ChipDesign-BV/sg13g2_stdcell_hv/spice/sg13g2_stdcell_hv.spice

************************************************************************
*
* sg13g2_stdcell_hv -- thick-oxide (3.3 V) standard cell library
*
* Derived from the IHP SG13G2 sg13g2_stdcell thin-oxide library by
* substituting the 3.3 V thick-oxide devices. Topology, pin names and pin
* order are unchanged from the thin-oxide cells.
*
*   model   sg13_lv_{n,p}mos -> sg13_hv_{n,p}mos
*   length  L -> max(L, 450 nm)     DRC Gat.a3, min gate length of the 3.3 V FET
*   width   NMOS unchanged; PMOS x 2.4
*           so the inverter switching threshold stays at Vm/VDD = 0.5046,
*           the value the thin-oxide library is sized to
*   as/ad/ps/pd recomputed from the HV model deck geometry (z1=0.34u, z2=0.38u)
*
* Generated 2026-08-03 by work/gen_hv_lib.py
*
* Original library Copyright 2023 IHP PDK Authors, Apache License 2.0.
* This derived work is distributed under the same terms.
*
************************************************************************


* Library name: sg13g2_stdcell_hv
* Cell name: sg13g2_hv_a21o_1
* View name: schematic
.subckt sg13g2_hv_a21o_1 X A1 A2 B1 VDD VSS
XN0 net1 A1 net2 VSS sg13_hv_nmos w=0.640u l=0.450u ng=1 ad=2.176e-13 as=2.176e-13 pd=1.96e-06 ps=1.96e-06 m=1
XN1 net2 A2 VSS VSS sg13_hv_nmos w=0.640u l=0.450u ng=1 ad=2.176e-13 as=2.176e-13 pd=1.96e-06 ps=1.96e-06 m=1
XN2 net1 B1 VSS VSS sg13_hv_nmos w=0.640u l=0.450u ng=1 ad=2.176e-13 as=2.176e-13 pd=1.96e-06 ps=1.96e-06 m=1
XN3 X net1 VSS VSS sg13_hv_nmos w=0.740u l=0.450u ng=1 ad=2.516e-13 as=2.516e-13 pd=2.16e-06 ps=2.16e-06 m=1
XP2 net1 B1 net3 VDD sg13_hv_pmos w=2.400u l=0.450u ng=1 ad=8.16e-13 as=8.16e-13 pd=5.48e-06 ps=5.48e-06 m=1
XP0 net3 A1 VDD VDD sg13_hv_pmos w=2.400u l=0.450u ng=1 ad=8.16e-13 as=8.16e-13 pd=5.48e-06 ps=5.48e-06 m=1
XP1 net3 A2 VDD VDD sg13_hv_pmos w=2.400u l=0.450u ng=1 ad=8.16e-13 as=8.16e-13 pd=5.48e-06 ps=5.48e-06 m=1
XP3 X net1 VDD VDD sg13_hv_pmos w=2.690u l=0.450u ng=1 ad=9.146e-13 as=9.146e-13 pd=6.06e-06 ps=6.06e-06 m=1
.ends
* End of subcircuit definition.

* Library name: sg13g2_stdcell_hv
* Cell name: sg13g2_hv_a21o_2
* View name: schematic
.subckt sg13g2_hv_a21o_2 X A1 A2 B1 VDD VSS
XN0 net1 A1 net2 VSS sg13_hv_nmos w=0.740u l=0.450u ng=1 ad=2.516e-13 as=2.516e-13 pd=2.16e-06 ps=2.16e-06 m=1
XN1 net2 A2 VSS VSS sg13_hv_nmos w=0.740u l=0.450u ng=1 ad=2.516e-13 as=2.516e-13 pd=2.16e-06 ps=2.16e-06 m=1
XN2 net1 B1 VSS VSS sg13_hv_nmos w=0.740u l=0.450u ng=1 ad=2.516e-13 as=2.516e-13 pd=2.16e-06 ps=2.16e-06 m=1
XN3 X net1 VSS VSS sg13_hv_nmos w=1.480u l=0.450u ng=2 ad=2.812e-13 as=5.032e-13 pd=2.24e-06 ps=4.32e-06 m=1
XP2 net1 B1 net3 VDD sg13_hv_pmos w=2.400u l=0.450u ng=1 ad=8.16e-13 as=8.16e-13 pd=5.48e-06 ps=5.48e-06 m=1
XP0 net3 A1 VDD VDD sg13_hv_pmos w=2.400u l=0.450u ng=1 ad=8.16e-13 as=8.16e-13 pd=5.48e-06 ps=5.48e-06 m=1
XP1 net3 A2 VDD VDD sg13_hv_pmos w=2.400u l=0.450u ng=1 ad=8.16e-13 as=8.16e-13 pd=5.48e-06 ps=5.48e-06 m=1
XP3 X net1 VDD VDD sg13_hv_pmos w=5.380u l=0.450u ng=2 ad=1.0222e-12 as=1.8292e-12 pd=6.14e-06 ps=1.212e-05 m=1
.ends
* End of subcircuit definition.

* Library name: sg13g2_stdcell_hv
* Cell name: sg13g2_hv_a21oi_1
* View name: schematic
.subckt sg13g2_hv_a21oi_1 Y A1 A2 B1 VDD VSS
XN0 Y B1 VSS VSS sg13_hv_nmos w=0.740u l=0.450u ng=1 ad=2.516e-13 as=2.516e-13 pd=2.16e-06 ps=2.16e-06 m=1
XN2 net1 A2 VSS VSS sg13_hv_nmos w=0.740u l=0.450u ng=1 ad=2.516e-13 as=2.516e-13 pd=2.16e-06 ps=2.16e-06 m=1
XN1 Y A1 net1 VSS sg13_hv_nmos w=0.740u l=0.450u ng=1 ad=2.516e-13 as=2.516e-13 pd=2.16e-06 ps=2.16e-06 m=1
XP2 Y B1 net2 VDD sg13_hv_pmos w=2.690u l=0.450u ng=1 ad=9.146e-13 as=9.146e-13 pd=6.06e-06 ps=6.06e-06 m=1
XP1 net2 A2 VDD VDD sg13_hv_pmos w=2.690u l=0.450u ng=1 ad=9.146e-13 as=9.146e-13 pd=6.06e-06 ps=6.06e-06 m=1
XP0 net2 A1 VDD VDD sg13_hv_pmos w=2.690u l=0.450u ng=1 ad=9.146e-13 as=9.146e-13 pd=6.06e-06 ps=6.06e-06 m=1
.ends
* End of subcircuit definition.

* Library name: sg13g2_stdcell_hv
* Cell name: sg13g2_hv_a21oi_2
* View name: schematic
.subckt sg13g2_hv_a21oi_2 Y A1 A2 B1 VDD VSS
XN0 Y B1 VSS VSS sg13_hv_nmos w=1.480u l=0.450u ng=2 ad=2.812e-13 as=5.032e-13 pd=2.24e-06 ps=4.32e-06 m=1
XN2 net2 A2 VSS VSS sg13_hv_nmos w=1.480u l=0.450u ng=2 ad=2.812e-13 as=5.032e-13 pd=2.24e-06 ps=4.32e-06 m=1
XN1 Y A1 net2 VSS sg13_hv_nmos w=1.480u l=0.450u ng=2 ad=2.812e-13 as=5.032e-13 pd=2.24e-06 ps=4.32e-06 m=1
XP2 Y B1 net1 VDD sg13_hv_pmos w=5.380u l=0.450u ng=2 ad=1.0222e-12 as=1.8292e-12 pd=6.14e-06 ps=1.212e-05 m=1
XP1 net1 A2 VDD VDD sg13_hv_pmos w=5.380u l=0.450u ng=2 ad=1.0222e-12 as=1.8292e-12 pd=6.14e-06 ps=1.212e-05 m=1
XP0 net1 A1 VDD VDD sg13_hv_pmos w=5.380u l=0.450u ng=2 ad=1.0222e-12 as=1.8292e-12 pd=6.14e-06 ps=1.212e-05 m=1
.ends
* End of subcircuit definition.

* Library name: sg13g2_stdcell_hv
* Cell name: sg13g2_hv_a221oi_1
* View name: schematic
.subckt sg13g2_hv_a221oi_1 Y A1 A2 B1 B2 C1 VDD VSS
XP2 Y C1 net3 VDD sg13_hv_pmos w=2.690u l=0.450u ng=1 ad=9.146e-13 as=9.146e-13 pd=6.06e-06 ps=6.06e-06 m=1
XP4 net3 B2 net1 VDD sg13_hv_pmos w=2.690u l=0.450u ng=1 ad=9.146e-13 as=9.146e-13 pd=6.06e-06 ps=6.06e-06 m=1
XP1 net3 B1 net1 VDD sg13_hv_pmos w=2.690u l=0.450u ng=1 ad=9.146e-13 as=9.146e-13 pd=6.06e-06 ps=6.06e-06 m=1
XP3 net1 A2 VDD VDD sg13_hv_pmos w=2.690u l=0.450u ng=1 ad=9.146e-13 as=9.146e-13 pd=6.06e-06 ps=6.06e-06 m=1
XP0 net1 A1 VDD VDD sg13_hv_pmos w=2.690u l=0.450u ng=1 ad=9.146e-13 as=9.146e-13 pd=6.06e-06 ps=6.06e-06 m=1
XN4 Y C1 VSS VSS sg13_hv_nmos w=0.740u l=0.450u ng=1 ad=2.516e-13 as=2.516e-13 pd=2.16e-06 ps=2.16e-06 m=1
XN3 net4 B2 VSS VSS sg13_hv_nmos w=0.740u l=0.450u ng=1 ad=2.516e-13 as=2.516e-13 pd=2.16e-06 ps=2.16e-06 m=1
XN2 Y B1 net4 VSS sg13_hv_nmos w=0.740u l=0.450u ng=1 ad=2.516e-13 as=2.516e-13 pd=2.16e-06 ps=2.16e-06 m=1
XN1 net2 A2 VSS VSS sg13_hv_nmos w=0.740u l=0.450u ng=1 ad=2.516e-13 as=2.516e-13 pd=2.16e-06 ps=2.16e-06 m=1
XN0 Y A1 net2 VSS sg13_hv_nmos w=0.740u l=0.450u ng=1 ad=2.516e-13 as=2.516e-13 pd=2.16e-06 ps=2.16e-06 m=1
.ends
* End of subcircuit definition.

* Library name: sg13g2_stdcell_hv
* Cell name: sg13g2_hv_and2_1
* View name: schematic
.subckt sg13g2_hv_and2_1 X A B VDD VSS
XN0 net4 A net2 VSS sg13_hv_nmos w=0.640u l=0.450u ng=1 ad=2.176e-13 as=2.176e-13 pd=1.96e-06 ps=1.96e-06 m=1
XN2 X net4 VSS VSS sg13_hv_nmos w=0.740u l=0.450u ng=1 ad=2.516e-13 as=2.516e-13 pd=2.16e-06 ps=2.16e-06 m=1
XN1 net2 B VSS VSS sg13_hv_nmos w=0.640u l=0.450u ng=1 ad=2.176e-13 as=2.176e-13 pd=1.96e-06 ps=1.96e-06 m=1
XP0 net4 B VDD VDD sg13_hv_pmos w=2.015u l=0.450u ng=1 ad=6.851e-13 as=6.851e-13 pd=4.71e-06 ps=4.71e-06 m=1
XP2 X net4 VDD VDD sg13_hv_pmos w=2.690u l=0.450u ng=1 ad=9.146e-13 as=9.146e-13 pd=6.06e-06 ps=6.06e-06 m=1
XP1 net4 A VDD VDD sg13_hv_pmos w=2.015u l=0.450u ng=1 ad=6.851e-13 as=6.851e-13 pd=4.71e-06 ps=4.71e-06 m=1
.ends
* End of subcircuit definition.

* Library name: sg13g2_stdcell_hv
* Cell name: sg13g2_hv_and2_2
* View name: schematic
.subckt sg13g2_hv_and2_2 X A B VDD VSS
XN0 net1 A net2 VSS sg13_hv_nmos w=0.640u l=0.450u ng=1 ad=2.176e-13 as=2.176e-13 pd=1.96e-06 ps=1.96e-06 m=1
XN2 X net1 VSS VSS sg13_hv_nmos w=1.480u l=0.450u ng=2 ad=2.812e-13 as=5.032e-13 pd=2.24e-06 ps=4.32e-06 m=1
XN1 net2 B VSS VSS sg13_hv_nmos w=0.640u l=0.450u ng=1 ad=2.176e-13 as=2.176e-13 pd=1.96e-06 ps=1.96e-06 m=1
XP0 net1 B VDD VDD sg13_hv_pmos w=2.015u l=0.450u ng=1 ad=6.851e-13 as=6.851e-13 pd=4.71e-06 ps=4.71e-06 m=1
XP2 X net1 VDD VDD sg13_hv_pmos w=5.380u l=0.450u ng=2 ad=1.0222e-12 as=1.8292e-12 pd=6.14e-06 ps=1.212e-05 m=1
XP1 net1 A VDD VDD sg13_hv_pmos w=2.015u l=0.450u ng=1 ad=6.851e-13 as=6.851e-13 pd=4.71e-06 ps=4.71e-06 m=1
.ends
* End of subcircuit definition.

* Library name: sg13g2_stdcell_hv
* Cell name: sg13g2_hv_and3_1
* View name: schematic
.subckt sg13g2_hv_and3_1 X A B C VDD VSS
XN2 net3 C VSS VSS sg13_hv_nmos w=0.640u l=0.450u ng=1 ad=2.176e-13 as=2.176e-13 pd=1.96e-06 ps=1.96e-06 m=1
XN3 X net2 VSS VSS sg13_hv_nmos w=0.740u l=0.450u ng=1 ad=2.516e-13 as=2.516e-13 pd=2.16e-06 ps=2.16e-06 m=1
XN0 net2 A net1 VSS sg13_hv_nmos w=0.640u l=0.450u ng=1 ad=2.176e-13 as=2.176e-13 pd=1.96e-06 ps=1.96e-06 m=1
XN1 net1 B net3 VSS sg13_hv_nmos w=0.640u l=0.450u ng=1 ad=2.176e-13 as=2.176e-13 pd=1.96e-06 ps=1.96e-06 m=1
XP3 X net2 VDD VDD sg13_hv_pmos w=2.690u l=0.450u ng=1 ad=9.146e-13 as=9.146e-13 pd=6.06e-06 ps=6.06e-06 m=1
XP1 net2 B VDD VDD sg13_hv_pmos w=2.015u l=0.450u ng=1 ad=6.851e-13 as=6.851e-13 pd=4.71e-06 ps=4.71e-06 m=1
XP2 net2 A VDD VDD sg13_hv_pmos w=2.015u l=0.450u ng=1 ad=6.851e-13 as=6.851e-13 pd=4.71e-06 ps=4.71e-06 m=1
XP0 net2 C VDD VDD sg13_hv_pmos w=2.015u l=0.450u ng=1 ad=6.851e-13 as=6.851e-13 pd=4.71e-06 ps=4.71e-06 m=1
.ends
* End of subcircuit definition.

* Library name: sg13g2_stdcell_hv
* Cell name: sg13g2_hv_and3_2
* View name: schematic
.subckt sg13g2_hv_and3_2 X A B C VDD VSS
XN2 net3 C VSS VSS sg13_hv_nmos w=0.640u l=0.450u ng=1 ad=2.176e-13 as=2.176e-13 pd=1.96e-06 ps=1.96e-06 m=1
XN3 X net2 VSS VSS sg13_hv_nmos w=1.480u l=0.450u ng=2 ad=2.812e-13 as=5.032e-13 pd=2.24e-06 ps=4.32e-06 m=1
XN0 net2 A net1 VSS sg13_hv_nmos w=0.640u l=0.450u ng=1 ad=2.176e-13 as=2.176e-13 pd=1.96e-06 ps=1.96e-06 m=1
XN1 net1 B net3 VSS sg13_hv_nmos w=0.640u l=0.450u ng=1 ad=2.176e-13 as=2.176e-13 pd=1.96e-06 ps=1.96e-06 m=1
XP3 X net2 VDD VDD sg13_hv_pmos w=5.380u l=0.450u ng=2 ad=1.0222e-12 as=1.8292e-12 pd=6.14e-06 ps=1.212e-05 m=1
XP1 net2 B VDD VDD sg13_hv_pmos w=2.015u l=0.450u ng=1 ad=6.851e-13 as=6.851e-13 pd=4.71e-06 ps=4.71e-06 m=1
XP2 net2 A VDD VDD sg13_hv_pmos w=2.015u l=0.450u ng=1 ad=6.851e-13 as=6.851e-13 pd=4.71e-06 ps=4.71e-06 m=1
XP0 net2 C VDD VDD sg13_hv_pmos w=2.015u l=0.450u ng=1 ad=6.851e-13 as=6.851e-13 pd=4.71e-06 ps=4.71e-06 m=1
.ends
* End of subcircuit definition.

* Library name: sg13g2_stdcell_hv
* Cell name: sg13g2_hv_and4_1
* View name: schematic
.subckt sg13g2_hv_and4_1 X A B C D VDD VSS
XN3 net17 D VSS VSS sg13_hv_nmos w=0.640u l=0.450u ng=1 ad=2.176e-13 as=2.176e-13 pd=1.96e-06 ps=1.96e-06 m=1
XN2 net16 C net17 VSS sg13_hv_nmos w=0.640u l=0.450u ng=1 ad=2.176e-13 as=2.176e-13 pd=1.96e-06 ps=1.96e-06 m=1
XN1 net15 B net16 VSS sg13_hv_nmos w=0.640u l=0.450u ng=1 ad=2.176e-13 as=2.176e-13 pd=1.96e-06 ps=1.96e-06 m=1
XN0 net1 A net15 VSS sg13_hv_nmos w=0.640u l=0.450u ng=1 ad=2.176e-13 as=2.176e-13 pd=1.96e-06 ps=1.96e-06 m=1
XN4 X net1 VSS VSS sg13_hv_nmos w=0.740u l=0.450u ng=1 ad=2.516e-13 as=2.516e-13 pd=2.16e-06 ps=2.16e-06 m=1
XP3 net1 A VDD VDD sg13_hv_pmos w=2.015u l=0.450u ng=1 ad=6.851e-13 as=6.851e-13 pd=4.71e-06 ps=4.71e-06 m=1
XP4 X net1 VDD VDD sg13_hv_pmos w=2.690u l=0.450u ng=1 ad=9.146e-13 as=9.146e-13 pd=6.06e-06 ps=6.06e-06 m=1
XP0 net1 D VDD VDD sg13_hv_pmos w=2.015u l=0.450u ng=1 ad=6.851e-13 as=6.851e-13 pd=4.71e-06 ps=4.71e-06 m=1
XP1 net1 C VDD VDD sg13_hv_pmos w=2.015u l=0.450u ng=1 ad=6.851e-13 as=6.851e-13 pd=4.71e-06 ps=4.71e-06 m=1
XP2 net1 B VDD VDD sg13_hv_pmos w=2.015u l=0.450u ng=1 ad=6.851e-13 as=6.851e-13 pd=4.71e-06 ps=4.71e-06 m=1
.ends
* End of subcircuit definition.

* Library name: sg13g2_stdcell_hv
* Cell name: sg13g2_hv_and4_2
* View name: schematic
.subckt sg13g2_hv_and4_2 X A B C D VDD VSS
XN3 net17 D VSS VSS sg13_hv_nmos w=0.640u l=0.450u ng=1 ad=2.176e-13 as=2.176e-13 pd=1.96e-06 ps=1.96e-06 m=1
XN2 net16 C net17 VSS sg13_hv_nmos w=0.640u l=0.450u ng=1 ad=2.176e-13 as=2.176e-13 pd=1.96e-06 ps=1.96e-06 m=1
XN1 net15 B net16 VSS sg13_hv_nmos w=0.640u l=0.450u ng=1 ad=2.176e-13 as=2.176e-13 pd=1.96e-06 ps=1.96e-06 m=1
XN0 net1 A net15 VSS sg13_hv_nmos w=0.640u l=0.450u ng=1 ad=2.176e-13 as=2.176e-13 pd=1.96e-06 ps=1.96e-06 m=1
XN4 X net1 VSS VSS sg13_hv_nmos w=1.480u l=0.450u ng=2 ad=2.812e-13 as=5.032e-13 pd=2.24e-06 ps=4.32e-06 m=1
XP3 net1 A VDD VDD sg13_hv_pmos w=2.015u l=0.450u ng=1 ad=6.851e-13 as=6.851e-13 pd=4.71e-06 ps=4.71e-06 m=1
XP4 X net1 VDD VDD sg13_hv_pmos w=5.380u l=0.450u ng=2 ad=1.0222e-12 as=1.8292e-12 pd=6.14e-06 ps=1.212e-05 m=1
XP0 net1 D VDD VDD sg13_hv_pmos w=2.015u l=0.450u ng=1 ad=6.851e-13 as=6.851e-13 pd=4.71e-06 ps=4.71e-06 m=1
XP1 net1 C VDD VDD sg13_hv_pmos w=2.015u l=0.450u ng=1 ad=6.851e-13 as=6.851e-13 pd=4.71e-06 ps=4.71e-06 m=1
XP2 net1 B VDD VDD sg13_hv_pmos w=2.015u l=0.450u ng=1 ad=6.851e-13 as=6.851e-13 pd=4.71e-06 ps=4.71e-06 m=1
.ends
* End of subcircuit definition.

* Library name: sg13g2_stdcell_hv
* Cell name: sg13g2_hv_antennanp
* View name: schematic
.subckt sg13g2_hv_antennanp A VDD VSS
XD1 VSS A dantenna l=780n w=780n m=1
XD0 A VDD dpantenna l=1.34u w=1.05u m=1
.ends
* End of subcircuit definition.

* Library name: sg13g2_stdcell_hv
* Cell name: sg13g2_hv_buf_1
* View name: schematic
.subckt sg13g2_hv_buf_1 X A VDD VSS
XN0 net1 A VSS VSS sg13_hv_nmos w=0.550u l=0.450u ng=1 ad=1.87e-13 as=1.87e-13 pd=1.78e-06 ps=1.78e-06 m=1
XN1 X net1 VSS VSS sg13_hv_nmos w=0.740u l=0.450u ng=1 ad=2.516e-13 as=2.516e-13 pd=2.16e-06 ps=2.16e-06 m=1
XP1 X net1 VDD VDD sg13_hv_pmos w=2.690u l=0.450u ng=1 ad=9.146e-13 as=9.146e-13 pd=6.06e-06 ps=6.06e-06 m=1
XP0 net1 A VDD VDD sg13_hv_pmos w=2.015u l=0.450u ng=1 ad=6.851e-13 as=6.851e-13 pd=4.71e-06 ps=4.71e-06 m=1
.ends
* End of subcircuit definition.

* Library name: sg13g2_stdcell_hv
* Cell name: sg13g2_hv_buf_16
* View name: schematic
.subckt sg13g2_hv_buf_16 X A VDD VSS
XN0 net1 A VSS VSS sg13_hv_nmos w=4.440u l=0.450u ng=6 ad=8.436e-13 as=1.0656e-12 pd=6.72e-06 ps=8.8e-06 m=1
XN1 X net1 VSS VSS sg13_hv_nmos w=11.840u l=0.450u ng=16 ad=2.2496e-12 as=2.4716e-12 pd=1.792e-05 ps=2e-05 m=1
XP1 X net1 VDD VDD sg13_hv_pmos w=43.040u l=0.450u ng=16 ad=8.1776e-12 as=8.9846e-12 pd=4.912e-05 ps=5.51e-05 m=1
XP0 net1 A VDD VDD sg13_hv_pmos w=16.140u l=0.450u ng=6 ad=3.0666e-12 as=3.8736e-12 pd=1.842e-05 ps=2.44e-05 m=1
.ends
* End of subcircuit definition.

* Library name: sg13g2_stdcell_hv
* Cell name: sg13g2_hv_buf_2
* View name: schematic
.subckt sg13g2_hv_buf_2 X A VDD VSS
XN0 net1 A VSS VSS sg13_hv_nmos w=0.640u l=0.450u ng=1 ad=2.176e-13 as=2.176e-13 pd=1.96e-06 ps=1.96e-06 m=1
XN1 X net1 VSS VSS sg13_hv_nmos w=1.480u l=0.450u ng=2 ad=2.812e-13 as=5.032e-13 pd=2.24e-06 ps=4.32e-06 m=1
XP1 X net1 VDD VDD sg13_hv_pmos w=5.380u l=0.450u ng=2 ad=1.0222e-12 as=1.8292e-12 pd=6.14e-06 ps=1.212e-05 m=1
XP0 net1 A VDD VDD sg13_hv_pmos w=2.400u l=0.450u ng=1 ad=8.16e-13 as=8.16e-13 pd=5.48e-06 ps=5.48e-06 m=1
.ends
* End of subcircuit definition.

* Library name: sg13g2_stdcell_hv
* Cell name: sg13g2_hv_buf_4
* View name: schematic
.subckt sg13g2_hv_buf_4 X A VDD VSS
XN0 net1 A VSS VSS sg13_hv_nmos w=0.740u l=0.450u ng=1 ad=2.516e-13 as=2.516e-13 pd=2.16e-06 ps=2.16e-06 m=1
XN1 X net1 VSS VSS sg13_hv_nmos w=2.960u l=0.450u ng=4 ad=5.624e-13 as=7.844e-13 pd=4.48e-06 ps=6.56e-06 m=1
XP1 X net1 VDD VDD sg13_hv_pmos w=10.760u l=0.450u ng=4 ad=2.0444e-12 as=2.8514e-12 pd=1.228e-05 ps=1.826e-05 m=1
XP0 net1 A VDD VDD sg13_hv_pmos w=4.030u l=0.450u ng=2 ad=7.657e-13 as=1.3702e-12 pd=4.79e-06 ps=9.42e-06 m=1
.ends
* End of subcircuit definition.

* Library name: sg13g2_stdcell_hv
* Cell name: sg13g2_hv_buf_8
* View name: schematic
.subckt sg13g2_hv_buf_8 X A VDD VSS
XN0 net1 A VSS VSS sg13_hv_nmos w=2.220u l=0.450u ng=3 ad=5.328e-13 as=5.328e-13 pd=4.4e-06 ps=4.4e-06 m=1
XN1 X net1 VSS VSS sg13_hv_nmos w=5.920u l=0.450u ng=8 ad=1.1248e-12 as=1.3468e-12 pd=8.96e-06 ps=1.104e-05 m=1
XP1 X net1 VDD VDD sg13_hv_pmos w=21.520u l=0.450u ng=8 ad=4.0888e-12 as=4.8958e-12 pd=2.456e-05 ps=3.054e-05 m=1
XP0 net1 A VDD VDD sg13_hv_pmos w=8.070u l=0.450u ng=3 ad=1.9368e-12 as=1.9368e-12 pd=1.22e-05 ps=1.22e-05 m=1
.ends
* End of subcircuit definition.

* Library name: sg13g2_stdcell_hv
* Cell name: sg13g2_hv_decap_4
* View name: schematic
.subckt sg13g2_hv_decap_4 VDD VSS
XN0 VSS VDD VSS VSS sg13_hv_nmos w=0.420u l=1.000u ng=1 ad=1.428e-13 as=1.428e-13 pd=1.52e-06 ps=1.52e-06 m=1
XP0 VDD VSS VDD VDD sg13_hv_pmos w=2.400u l=1.000u ng=1 ad=8.16e-13 as=8.16e-13 pd=5.48e-06 ps=5.48e-06 m=1
.ends
* End of subcircuit definition.

* Library name: sg13g2_stdcell_hv
* Cell name: sg13g2_hv_decap_8
* View name: schematic
.subckt sg13g2_hv_decap_8 VDD VSS
XN0 VSS VDD VSS VSS sg13_hv_nmos w=0.840u l=1.000u ng=2 ad=1.596e-13 as=2.856e-13 pd=1.6e-06 ps=3.04e-06 m=1
XP0 VDD VSS VDD VDD sg13_hv_pmos w=4.800u l=1.000u ng=2 ad=9.12e-13 as=1.632e-12 pd=5.56e-06 ps=1.096e-05 m=1
.ends
* End of subcircuit definition.

* Library name: sg13g2_stdcell_hv
* Cell name: sg13g2_hv_dfrbp_1
* View name: schematic
.subckt sg13g2_hv_dfrbp_1 Q Q_N CLK D RESET_B VDD VSS
XN11 net12 net2 VSS VSS sg13_hv_nmos w=0.420u l=0.450u ng=1 ad=1.428e-13 as=1.428e-13 pd=1.52e-06 ps=1.52e-06 m=1
XN10 net5 clkneg net12 VSS sg13_hv_nmos w=0.420u l=0.450u ng=1 ad=1.428e-13 as=1.428e-13 pd=1.52e-06 ps=1.52e-06 m=1
XN12 net2 net5 net11 VSS sg13_hv_nmos w=0.420u l=0.450u ng=1 ad=1.428e-13 as=1.428e-13 pd=1.52e-06 ps=1.52e-06 m=1
XN13 net11 RESET_B VSS VSS sg13_hv_nmos w=0.420u l=0.450u ng=1 ad=1.428e-13 as=1.428e-13 pd=1.52e-06 ps=1.52e-06 m=1
XN14 Q_N net5 VSS VSS sg13_hv_nmos w=0.740u l=0.450u ng=1 ad=2.516e-13 as=2.516e-13 pd=2.16e-06 ps=2.16e-06 m=1
XN0 Db D net10 VSS sg13_hv_nmos w=0.420u l=0.450u ng=1 ad=1.428e-13 as=1.428e-13 pd=1.52e-06 ps=1.52e-06 m=1
XN1 net10 RESET_B VSS VSS sg13_hv_nmos w=0.420u l=0.450u ng=1 ad=1.428e-13 as=1.428e-13 pd=1.52e-06 ps=1.52e-06 m=1
XN4 Db clkneg net6 VSS sg13_hv_nmos w=0.420u l=0.450u ng=1 ad=1.428e-13 as=1.428e-13 pd=1.52e-06 ps=1.52e-06 m=1
XN5 net6 clkpos net9 VSS sg13_hv_nmos w=0.420u l=0.450u ng=1 ad=1.428e-13 as=1.428e-13 pd=1.52e-06 ps=1.52e-06 m=1
XN6 net9 net4 net8 VSS sg13_hv_nmos w=0.420u l=0.450u ng=1 ad=1.428e-13 as=1.428e-13 pd=1.52e-06 ps=1.52e-06 m=1
XN7 net8 RESET_B VSS VSS sg13_hv_nmos w=0.420u l=0.450u ng=1 ad=1.428e-13 as=1.428e-13 pd=1.52e-06 ps=1.52e-06 m=1
XN8 net4 net6 VSS VSS sg13_hv_nmos w=0.740u l=0.450u ng=1 ad=2.516e-13 as=2.516e-13 pd=2.16e-06 ps=2.16e-06 m=1
XN2 clkneg CLK VSS VSS sg13_hv_nmos w=0.740u l=0.450u ng=1 ad=2.516e-13 as=2.516e-13 pd=2.16e-06 ps=2.16e-06 m=1
XN9 net4 clkpos net5 VSS sg13_hv_nmos w=0.740u l=0.450u ng=1 ad=2.516e-13 as=2.516e-13 pd=2.16e-06 ps=2.16e-06 m=1
XN3 clkpos clkneg VSS VSS sg13_hv_nmos w=0.740u l=0.450u ng=1 ad=2.516e-13 as=2.516e-13 pd=2.16e-06 ps=2.16e-06 m=1
XN16 Q net1 VSS VSS sg13_hv_nmos w=0.740u l=0.450u ng=1 ad=2.516e-13 as=2.516e-13 pd=2.16e-06 ps=2.16e-06 m=1
XN15 net1 net5 VSS VSS sg13_hv_nmos w=0.740u l=0.450u ng=1 ad=2.516e-13 as=2.516e-13 pd=2.16e-06 ps=2.16e-06 m=1
XP11 net5 clkpos net3 VDD sg13_hv_pmos w=1.010u l=0.450u ng=1 ad=3.434e-13 as=3.434e-13 pd=2.7e-06 ps=2.7e-06 m=1
XP12 net2 net5 VDD VDD sg13_hv_pmos w=1.010u l=0.450u ng=1 ad=3.434e-13 as=3.434e-13 pd=2.7e-06 ps=2.7e-06 m=1
XP13 net2 RESET_B VDD VDD sg13_hv_pmos w=1.010u l=0.450u ng=1 ad=3.434e-13 as=3.434e-13 pd=2.7e-06 ps=2.7e-06 m=1
XP14 Q_N net5 VDD VDD sg13_hv_pmos w=2.690u l=0.450u ng=1 ad=9.146e-13 as=9.146e-13 pd=6.06e-06 ps=6.06e-06 m=1
XP4 Db clkpos net6 VDD sg13_hv_pmos w=1.010u l=0.450u ng=1 ad=3.434e-13 as=3.434e-13 pd=2.7e-06 ps=2.7e-06 m=1
XP0 Db RESET_B VDD VDD sg13_hv_pmos w=1.010u l=0.450u ng=1 ad=3.434e-13 as=3.434e-13 pd=2.7e-06 ps=2.7e-06 m=1
XP1 Db D VDD VDD sg13_hv_pmos w=1.010u l=0.450u ng=1 ad=3.434e-13 as=3.434e-13 pd=2.7e-06 ps=2.7e-06 m=1
XP5 net7 net4 VDD VDD sg13_hv_pmos w=1.010u l=0.450u ng=1 ad=3.434e-13 as=3.434e-13 pd=2.7e-06 ps=2.7e-06 m=1
XP6 net6 clkneg net7 VDD sg13_hv_pmos w=1.010u l=0.450u ng=1 ad=3.434e-13 as=3.434e-13 pd=2.7e-06 ps=2.7e-06 m=1
XP7 net6 RESET_B VDD VDD sg13_hv_pmos w=1.010u l=0.450u ng=1 ad=3.434e-13 as=3.434e-13 pd=2.7e-06 ps=2.7e-06 m=1
XP2 clkneg CLK VDD VDD sg13_hv_pmos w=2.690u l=0.450u ng=1 ad=9.146e-13 as=9.146e-13 pd=6.06e-06 ps=6.06e-06 m=1
XP3 clkpos clkneg VDD VDD sg13_hv_pmos w=2.690u l=0.450u ng=1 ad=9.146e-13 as=9.146e-13 pd=6.06e-06 ps=6.06e-06 m=1
XP8 net4 net6 VDD VDD sg13_hv_pmos w=2.400u l=0.450u ng=1 ad=8.16e-13 as=8.16e-13 pd=5.48e-06 ps=5.48e-06 m=1
XP9 net4 clkneg net5 VDD sg13_hv_pmos w=2.400u l=0.450u ng=1 ad=8.16e-13 as=8.16e-13 pd=5.48e-06 ps=5.48e-06 m=1
XP16 Q net1 VDD VDD sg13_hv_pmos w=2.690u l=0.450u ng=1 ad=9.146e-13 as=9.146e-13 pd=6.06e-06 ps=6.06e-06 m=1
XP10 net3 net2 VDD VDD sg13_hv_pmos w=1.010u l=0.450u ng=1 ad=3.434e-13 as=3.434e-13 pd=2.7e-06 ps=2.7e-06 m=1
XP15 net1 net5 VDD VDD sg13_hv_pmos w=2.690u l=0.450u ng=1 ad=9.146e-13 as=9.146e-13 pd=6.06e-06 ps=6.06e-06 m=1
.ends
* End of subcircuit definition.

* Library name: sg13g2_stdcell_hv
* Cell name: sg13g2_hv_dfrbp_2
* View name: schematic
.subckt sg13g2_hv_dfrbp_2 Q Q_N CLK D RESET_B VDD VSS
XN11 net12 net2 VSS VSS sg13_hv_nmos w=0.420u l=0.450u ng=1 ad=1.428e-13 as=1.428e-13 pd=1.52e-06 ps=1.52e-06 m=1
XN10 net5 clkneg net12 VSS sg13_hv_nmos w=0.420u l=0.450u ng=1 ad=1.428e-13 as=1.428e-13 pd=1.52e-06 ps=1.52e-06 m=1
XN12 net2 net5 net11 VSS sg13_hv_nmos w=0.420u l=0.450u ng=1 ad=1.428e-13 as=1.428e-13 pd=1.52e-06 ps=1.52e-06 m=1
XN13 net11 RESET_B VSS VSS sg13_hv_nmos w=0.420u l=0.450u ng=1 ad=1.428e-13 as=1.428e-13 pd=1.52e-06 ps=1.52e-06 m=1
XN14 Q_N net5 VSS VSS sg13_hv_nmos w=1.480u l=0.450u ng=2 ad=2.812e-13 as=5.032e-13 pd=2.24e-06 ps=4.32e-06 m=1
XN0 Db D net10 VSS sg13_hv_nmos w=0.420u l=0.450u ng=1 ad=1.428e-13 as=1.428e-13 pd=1.52e-06 ps=1.52e-06 m=1
XN1 net10 RESET_B VSS VSS sg13_hv_nmos w=0.420u l=0.450u ng=1 ad=1.428e-13 as=1.428e-13 pd=1.52e-06 ps=1.52e-06 m=1
XN4 Db clkneg net6 VSS sg13_hv_nmos w=0.420u l=0.450u ng=1 ad=1.428e-13 as=1.428e-13 pd=1.52e-06 ps=1.52e-06 m=1
XN5 net6 clkpos net9 VSS sg13_hv_nmos w=0.420u l=0.450u ng=1 ad=1.428e-13 as=1.428e-13 pd=1.52e-06 ps=1.52e-06 m=1
XN6 net9 net4 net8 VSS sg13_hv_nmos w=0.420u l=0.450u ng=1 ad=1.428e-13 as=1.428e-13 pd=1.52e-06 ps=1.52e-06 m=1
XN7 net8 RESET_B VSS VSS sg13_hv_nmos w=0.420u l=0.450u ng=1 ad=1.428e-13 as=1.428e-13 pd=1.52e-06 ps=1.52e-06 m=1
XN8 net4 net6 VSS VSS sg13_hv_nmos w=0.740u l=0.450u ng=1 ad=2.516e-13 as=2.516e-13 pd=2.16e-06 ps=2.16e-06 m=1
XN2 clkneg CLK VSS VSS sg13_hv_nmos w=0.740u l=0.450u ng=1 ad=2.516e-13 as=2.516e-13 pd=2.16e-06 ps=2.16e-06 m=1
XN9 net4 clkpos net5 VSS sg13_hv_nmos w=0.740u l=0.450u ng=1 ad=2.516e-13 as=2.516e-13 pd=2.16e-06 ps=2.16e-06 m=1
XN3 clkpos clkneg VSS VSS sg13_hv_nmos w=0.740u l=0.450u ng=1 ad=2.516e-13 as=2.516e-13 pd=2.16e-06 ps=2.16e-06 m=1
XN16 Q net1 VSS VSS sg13_hv_nmos w=1.480u l=0.450u ng=2 ad=2.812e-13 as=5.032e-13 pd=2.24e-06 ps=4.32e-06 m=1
XN15 net1 net5 VSS VSS sg13_hv_nmos w=0.640u l=0.450u ng=1 ad=2.176e-13 as=2.176e-13 pd=1.96e-06 ps=1.96e-06 m=1
XP11 net5 clkpos net3 VDD sg13_hv_pmos w=1.010u l=0.450u ng=1 ad=3.434e-13 as=3.434e-13 pd=2.7e-06 ps=2.7e-06 m=1
XP12 net2 net5 VDD VDD sg13_hv_pmos w=1.010u l=0.450u ng=1 ad=3.434e-13 as=3.434e-13 pd=2.7e-06 ps=2.7e-06 m=1
XP13 net2 RESET_B VDD VDD sg13_hv_pmos w=1.010u l=0.450u ng=1 ad=3.434e-13 as=3.434e-13 pd=2.7e-06 ps=2.7e-06 m=1
XP14 Q_N net5 VDD VDD sg13_hv_pmos w=5.380u l=0.450u ng=2 ad=1.0222e-12 as=1.8292e-12 pd=6.14e-06 ps=1.212e-05 m=1
XP4 Db clkpos net6 VDD sg13_hv_pmos w=1.010u l=0.450u ng=1 ad=3.434e-13 as=3.434e-13 pd=2.7e-06 ps=2.7e-06 m=1
XP0 Db RESET_B VDD VDD sg13_hv_pmos w=1.010u l=0.450u ng=1 ad=3.434e-13 as=3.434e-13 pd=2.7e-06 ps=2.7e-06 m=1
XP1 Db D VDD VDD sg13_hv_pmos w=1.010u l=0.450u ng=1 ad=3.434e-13 as=3.434e-13 pd=2.7e-06 ps=2.7e-06 m=1
XP5 net7 net4 VDD VDD sg13_hv_pmos w=1.010u l=0.450u ng=1 ad=3.434e-13 as=3.434e-13 pd=2.7e-06 ps=2.7e-06 m=1
XP6 net6 clkneg net7 VDD sg13_hv_pmos w=1.010u l=0.450u ng=1 ad=3.434e-13 as=3.434e-13 pd=2.7e-06 ps=2.7e-06 m=1
XP7 net6 RESET_B VDD VDD sg13_hv_pmos w=1.010u l=0.450u ng=1 ad=3.434e-13 as=3.434e-13 pd=2.7e-06 ps=2.7e-06 m=1
XP2 clkneg CLK VDD VDD sg13_hv_pmos w=2.690u l=0.450u ng=1 ad=9.146e-13 as=9.146e-13 pd=6.06e-06 ps=6.06e-06 m=1
XP3 clkpos clkneg VDD VDD sg13_hv_pmos w=2.690u l=0.450u ng=1 ad=9.146e-13 as=9.146e-13 pd=6.06e-06 ps=6.06e-06 m=1
XP8 net4 net6 VDD VDD sg13_hv_pmos w=2.400u l=0.450u ng=1 ad=8.16e-13 as=8.16e-13 pd=5.48e-06 ps=5.48e-06 m=1
XP9 net4 clkneg net5 VDD sg13_hv_pmos w=2.400u l=0.450u ng=1 ad=8.16e-13 as=8.16e-13 pd=5.48e-06 ps=5.48e-06 m=1
XP16 Q net1 VDD VDD sg13_hv_pmos w=5.380u l=0.450u ng=2 ad=1.0222e-12 as=1.8292e-12 pd=6.14e-06 ps=1.212e-05 m=1
XP10 net3 net2 VDD VDD sg13_hv_pmos w=1.010u l=0.450u ng=1 ad=3.434e-13 as=3.434e-13 pd=2.7e-06 ps=2.7e-06 m=1
XP15 net1 net5 VDD VDD sg13_hv_pmos w=2.400u l=0.450u ng=1 ad=8.16e-13 as=8.16e-13 pd=5.48e-06 ps=5.48e-06 m=1
.ends
* End of subcircuit definition.

* Library name: sg13g2_stdcell_hv
* Cell name: sg13g2_hv_dlhq_1
* View name: schematic
.subckt sg13g2_hv_dlhq_1 Q D GATE VDD VSS
XP8 Q qint_b VDD VDD sg13_hv_pmos w=2.690u l=0.450u ng=1 ad=9.146e-13 as=9.146e-13 pd=6.06e-06 ps=6.06e-06 m=1
XP6 qint GATE_BB net8 VDD sg13_hv_pmos w=1.010u l=0.450u ng=1 ad=3.434e-13 as=3.434e-13 pd=2.7e-06 ps=2.7e-06 m=1
XP7 qint_b qint VDD VDD sg13_hv_pmos w=2.690u l=0.450u ng=1 ad=9.146e-13 as=9.146e-13 pd=6.06e-06 ps=6.06e-06 m=1
XP2 Db D VDD VDD sg13_hv_pmos w=2.015u l=0.450u ng=1 ad=6.851e-13 as=6.851e-13 pd=4.71e-06 ps=4.71e-06 m=1
XP0 GATE_B GATE VDD VDD sg13_hv_pmos w=2.015u l=0.450u ng=1 ad=6.851e-13 as=6.851e-13 pd=4.71e-06 ps=4.71e-06 m=1
XP1 GATE_BB GATE_B VDD VDD sg13_hv_pmos w=2.015u l=0.450u ng=1 ad=6.851e-13 as=6.851e-13 pd=4.71e-06 ps=4.71e-06 m=1
XP5 net8 qint_b VDD VDD sg13_hv_pmos w=1.010u l=0.450u ng=1 ad=3.434e-13 as=3.434e-13 pd=2.7e-06 ps=2.7e-06 m=1
XP4 net4 GATE_B qint VDD sg13_hv_pmos w=2.400u l=0.450u ng=1 ad=8.16e-13 as=8.16e-13 pd=5.48e-06 ps=5.48e-06 m=1
XP3 net4 Db VDD VDD sg13_hv_pmos w=2.400u l=0.450u ng=1 ad=8.16e-13 as=8.16e-13 pd=5.48e-06 ps=5.48e-06 m=1
XN0 GATE_B GATE VSS VSS sg13_hv_nmos w=0.740u l=0.450u ng=1 ad=2.516e-13 as=2.516e-13 pd=2.16e-06 ps=2.16e-06 m=1
XN1 GATE_BB GATE_B VSS VSS sg13_hv_nmos w=0.740u l=0.450u ng=1 ad=2.516e-13 as=2.516e-13 pd=2.16e-06 ps=2.16e-06 m=1
XN5 qint GATE_B net9 VSS sg13_hv_nmos w=0.420u l=0.450u ng=1 ad=1.428e-13 as=1.428e-13 pd=1.52e-06 ps=1.52e-06 m=1
XN8 Q qint_b VSS VSS sg13_hv_nmos w=0.740u l=0.450u ng=1 ad=2.516e-13 as=2.516e-13 pd=2.16e-06 ps=2.16e-06 m=1
XN4 net7 Db VSS VSS sg13_hv_nmos w=0.740u l=0.450u ng=1 ad=2.516e-13 as=2.516e-13 pd=2.16e-06 ps=2.16e-06 m=1
XN6 net9 qint_b VSS VSS sg13_hv_nmos w=0.420u l=0.450u ng=1 ad=1.428e-13 as=1.428e-13 pd=1.52e-06 ps=1.52e-06 m=1
XN7 qint_b qint VSS VSS sg13_hv_nmos w=0.740u l=0.450u ng=1 ad=2.516e-13 as=2.516e-13 pd=2.16e-06 ps=2.16e-06 m=1
XN3 qint GATE_BB net7 VSS sg13_hv_nmos w=0.740u l=0.450u ng=1 ad=2.516e-13 as=2.516e-13 pd=2.16e-06 ps=2.16e-06 m=1
XN2 Db D VSS VSS sg13_hv_nmos w=0.550u l=0.450u ng=1 ad=1.87e-13 as=1.87e-13 pd=1.78e-06 ps=1.78e-06 m=1
.ends
* End of subcircuit definition.

* Library name: sg13g2_stdcell_hv
* Cell name: sg13g2_hv_dlhr_1
* View name: schematic
.subckt sg13g2_hv_dlhr_1 Q Q_N D GATE RESET_B VDD VSS
XP8 qint_b RESET_B VDD VDD sg13_hv_pmos w=2.690u l=0.450u ng=1 ad=9.146e-13 as=9.146e-13 pd=6.06e-06 ps=6.06e-06 m=1
XP9 Q qint_b VDD VDD sg13_hv_pmos w=2.690u l=0.450u ng=1 ad=9.146e-13 as=9.146e-13 pd=6.06e-06 ps=6.06e-06 m=1
XP6 qint GATE_BB net11 VDD sg13_hv_pmos w=1.010u l=0.450u ng=1 ad=3.434e-13 as=3.434e-13 pd=2.7e-06 ps=2.7e-06 m=1
XP5 net11 qint_b VDD VDD sg13_hv_pmos w=1.010u l=0.450u ng=1 ad=3.434e-13 as=3.434e-13 pd=2.7e-06 ps=2.7e-06 m=1
XP4 qint GATE_B net2 VDD sg13_hv_pmos w=2.400u l=0.450u ng=1 ad=8.16e-13 as=8.16e-13 pd=5.48e-06 ps=5.48e-06 m=1
XP3 net2 Db VDD VDD sg13_hv_pmos w=2.400u l=0.450u ng=1 ad=8.16e-13 as=8.16e-13 pd=5.48e-06 ps=5.48e-06 m=1
XP2 Db D VDD VDD sg13_hv_pmos w=2.015u l=0.450u ng=1 ad=6.851e-13 as=6.851e-13 pd=4.71e-06 ps=4.71e-06 m=1
XP0 GATE_B GATE VDD VDD sg13_hv_pmos w=2.015u l=0.450u ng=1 ad=6.851e-13 as=6.851e-13 pd=4.71e-06 ps=4.71e-06 m=1
XP11 Q_N qintn_b VDD VDD sg13_hv_pmos w=2.690u l=0.450u ng=1 ad=9.146e-13 as=9.146e-13 pd=6.06e-06 ps=6.06e-06 m=1
XP7 qint_b qint VDD VDD sg13_hv_pmos w=2.690u l=0.450u ng=1 ad=9.146e-13 as=9.146e-13 pd=6.06e-06 ps=6.06e-06 m=1
XP1 GATE_BB GATE_B VDD VDD sg13_hv_pmos w=2.015u l=0.450u ng=1 ad=6.851e-13 as=6.851e-13 pd=4.71e-06 ps=4.71e-06 m=1
XP10 qintn_b qint_b VDD VDD sg13_hv_pmos w=2.015u l=0.450u ng=1 ad=6.851e-13 as=6.851e-13 pd=4.71e-06 ps=4.71e-06 m=1
XN7 qint_b qint net9 VSS sg13_hv_nmos w=0.740u l=0.450u ng=1 ad=2.516e-13 as=2.516e-13 pd=2.16e-06 ps=2.16e-06 m=1
XN8 net9 RESET_B VSS VSS sg13_hv_nmos w=0.740u l=0.450u ng=1 ad=2.516e-13 as=2.516e-13 pd=2.16e-06 ps=2.16e-06 m=1
XN5 qint GATE_B net7 VSS sg13_hv_nmos w=0.420u l=0.450u ng=1 ad=1.428e-13 as=1.428e-13 pd=1.52e-06 ps=1.52e-06 m=1
XN6 net7 qint_b VSS VSS sg13_hv_nmos w=0.420u l=0.450u ng=1 ad=1.428e-13 as=1.428e-13 pd=1.52e-06 ps=1.52e-06 m=1
XN9 Q qint_b VSS VSS sg13_hv_nmos w=0.740u l=0.450u ng=1 ad=2.516e-13 as=2.516e-13 pd=2.16e-06 ps=2.16e-06 m=1
XN3 qint GATE_BB net1 VSS sg13_hv_nmos w=0.640u l=0.450u ng=1 ad=2.176e-13 as=2.176e-13 pd=1.96e-06 ps=1.96e-06 m=1
XN4 net1 Db VSS VSS sg13_hv_nmos w=0.640u l=0.450u ng=1 ad=2.176e-13 as=2.176e-13 pd=1.96e-06 ps=1.96e-06 m=1
XN2 Db D VSS VSS sg13_hv_nmos w=0.550u l=0.450u ng=1 ad=1.87e-13 as=1.87e-13 pd=1.78e-06 ps=1.78e-06 m=1
XN0 GATE_B GATE VSS VSS sg13_hv_nmos w=0.740u l=0.450u ng=1 ad=2.516e-13 as=2.516e-13 pd=2.16e-06 ps=2.16e-06 m=1
XN11 Q_N qintn_b VSS VSS sg13_hv_nmos w=0.740u l=0.450u ng=1 ad=2.516e-13 as=2.516e-13 pd=2.16e-06 ps=2.16e-06 m=1
XN1 GATE_BB GATE_B VSS VSS sg13_hv_nmos w=0.740u l=0.450u ng=1 ad=2.516e-13 as=2.516e-13 pd=2.16e-06 ps=2.16e-06 m=1
XN10 qintn_b qint_b VSS VSS sg13_hv_nmos w=0.550u l=0.450u ng=1 ad=1.87e-13 as=1.87e-13 pd=1.78e-06 ps=1.78e-06 m=1
.ends
* End of subcircuit definition.
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
