ChipDesign-BV/sg13g2_stdcell_hv/(commit log)

2026-08-17 doc: characterization methods report (fo4.py vs CharLib vs lctime)
    Elaborate comparison of the three characterization methods behind the
    Liberty file, every statement backed by first-principles equations and
    source-level evidence: input capacitance as three windowed averages of
    Cin(v) (AC rail-biased / charge integration / constant-current slope),
    the Liberty slew convention, energy and leakage accounting, sequential
    pushout criteria, simulator-coupling pitfalls, and the verdict that
    lctime 0.0.26 cannot do charge integration as shipped but can with a
    three-part patch to characterize_input_capacitances().
2026-08-17 doc: fit equations to page width, mark reports Public
    Two display equations exceeded the A4 printable width; both are split or
    tightened at the source, and img.math-display gets max-width:100% as a
    safety net. Footer changed from Confidential to Public; both PDFs rebuilt
    with the Public footer.
2026-08-17 sch: tie-cell schematics match the tied-inverter implementation
    verify_sch.py caught sg13g2_hv_tiehi/tielo failing: gen_tie_cells.py builds
    the tie cells from inv_1 with the input tied to a rail (2 devices), but the
    schematics were still the retargeted four-transistor thin-oxide tie chains.
    Redrawn from the inv_1 schematic with the input pin replaced by the rail
    label; verify_sch.py now passes 84/84 cells, 920 devices, schematic and CDL
    both against SPICE.
    [sg13g2_hv_tiehi.sch, sg13g2_hv_tielo.sch]
2026-08-17 gds/lef: widen the 12 off-track pins that have room onto their tracks
    grid_align_pins.py --apply, previously documented but not applied: 12
    signal pins gain Metal1 to the nearest vertical track (each guarded for
    M1.b in the script); 11 remain off-track, unwidenable without violating
    M1.b. Re-signed-off: PDK run_drc.py clean of all cell rules on both the
    abutted two-row array and the shared-rail mixed-row array (only the 7
    chip-level density rules, as before), per-cell LVS 68/68 match, LEF
    regenerated.
2026-08-17 lib: measured tie-cell leakage; area provenance tool
    verify_lib.py failed on tiehi/tielo carrying no leakage_power group --
    synthesis reads that as zero. Rather than borrow inv_1's number (the
    README's original objection) the tie netlists are measured directly with
    the seq_leakage.py deck pattern: 0.0112 / 0.0130 nW. update_lib_area.py
    sets Liberty area from the LEF footprint and confirmed all 56 drawn
    Liberty cells already carry the exact LEF value (12 undrawn keep their
    documented estimates). verify_lib.py now passes.
2026-08-17 PDK contribution: view matrix, release notes, overlay assembly
    Preparation for the IHP-Open-PDK pull request:
    - work/view_matrix.py: per-cell x per-view coverage matrix; 56/84 cells
    complete in every view, every gap listed with its reason.
    - doc/ReleaseNotes.txt: PDK-facing summary in the upstream format.
    - work/make_pdk_pr.py: assembles the ihp-sg13g2/ overlay (libs.ref seven
    dirs, symbols+schematics merged into libs.tech/xschem/sg13g2_stdcells_hv
    with the $::SG13G2_HV_SCH pointer stripped -- same-directory resolution
    replaces it there -- and the KLayout macro with a PDK-relative GDS path).
    Verified: 84/84 overlay schematics netlist through the stripped symbols
    and match the SPI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
2026-08-17 doc: reports to rev. 4; make_pdk_pr.py targets the dev branch
    make_pdk_pr.py reworked for the IHP-Open-PDK dev conventions discovered
    during integration: dev keeps xschem views under libs.ref (1c0757e0 /
    c90378d8), so the library drops in unchanged and the xschem wiring is a
    two-line xschemrc patch (path append + ::SG13G2_HV_SCH); applied and
    verified against a dev checkout, 84/84 schematics netlist through the
    installed symbols. Library report rev. 4: 920 devices after the tie fix,
    tie cells present in the Liberty with measured leakage (not excluded),
    new verification rows (tie leakage, pin widening + re-signoff, dev-deck
    DRC/LVS re-run), and the upstream submission as IHP-Open-PDK PR #1103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
2026-08-17 librelane: SCL, liberty drive limits + physical stubs, install alignment
    Addresses Simon Dorrer's LibreLane smoke test of IHP-Open-PDK PR #1103:
    * librelane/ is a complete SCL (installed as
    libs.tech/librelane/sg13g2_stdcell_hv/): config.tcl on CoreSiteHV
    0.48 x 7.14 with HV driving/tie/fill/decap/diode/CTS cells,
    tracks.info, latch/mux techmaps, exclude lists, and sdfbbp_map.v --
    every posedge Yosys flop mapped onto the scan cell sg13g2_hv_sdfbbp_1
    (the only flop with layout + liberty), scan mux recycled as the enable
    mux, all 23 clocked mappings proven with equiv_induct against the
    Yosys cell semantics. Glue logic is fine-grained gates: the map runs
    after synth's lowering,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
2026-08-17 gds: N-wells to the strict analog HV rules (Magic NW.c1 clean)
    The retarget placed the well bottom for the DigiBnd digital rule
    (NW.c1.dig, 0.31 um N-well enclosure of HV P-active). Magic's SG13G2
    tech has no DigiBnd concept and applies the analog 0.62 um rules
    unconditionally, flagging every cell -- 25 nm short in 65 of 68,
    ~210 nm in mux4_1/slgcp_1 (IHP-Open-PDK issue #1107 tracks the tool
    gap). There is room to satisfy the strict rules in the well layer
    alone, so work/fix_well_nwc1.py rebuilds only the N-wells:
    * bottom edge 2.625 -> 2.570 um globally (bounded by NW.c1 from above
    and NW.d1 to the worst-case N-active top, 1.925 um, from below --
    also across any abutment);
    * deeper jog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
2026-08-18 gds/lef: draw the 16 remaining cells -- all 84 cells now have layouts
    The 1-D retarget skipped 18 cells; tiehi/tielo were built earlier by
    gen_tie_cells.py, and the remaining 16 (8 dfrbp/sdfrbp flip-flops, 4
    latches, ebufn_2/8, lgcp_1, sighold) are now generated per-cell:
    * Root cause of the skips: a p+ source finger butting into the VDD rail
    tap (plus, for some flops, an NMOS band crossing the library channel
    cut). Recipe (work/flop_pilot/gen_seq.py, work/cell_dev/*/gen_*.py):
    remove the butting fingers before the y-map, apply a per-cell insert
    split (rail + channel-cut + pSD inserts summing to the library's
    0.975 um) so every template band lands on the shipped positions and
    th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
2026-08-18 lib: characterize sg13g2_hv_sighold; class-aware liberty checks
    sighold is the one drawn-but-uncharacterized cell that needs no timing
    characterization at all -- the thin-oxide model is driver_type :
    bus_hold plus capacitance and per-state leakage, with zero timing
    groups -- so work/char_sighold.py measures it directly, the way the tie
    cells are measured.
    * Leakage: SH held at each rail by an ideal source at exactly VDD/0, so
    the keeper carries no steady-state current through the driving source
    and i(VDD) is the true subthreshold path. 0.0118 nW (SH) / 0.0224 nW
    (!SH) -- ~10^4 below the thin-oxide cell, the same ratio the tie cells
    show, for the same reason (thick oxide, 0.45-0.70 u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
2026-08-18 doc: reports to rev. 5 -- full layout coverage, strict wells, LibreLane, characterization methods
    Main report (rev. 5):
    * Scope, views and verification tables move from 68 drawn cells to all
    84; LEF 84 macros; LVS 84/84; every Liberty area now measured rather
    than partly estimated.
    * New section 4.1 on the 18 cells the library-wide 1-D map could not
    produce. They were not 18 hard cases but one shared root cause -- a p+
    source finger butting into the VDD rail tap -- and the per-cell recipe
    that follows from it (cut the finger, split the y-insert per cell,
    restore the finger at the butted-junction convention, rebuild the
    well). No device W/L/connectivity deviates from the CDL, so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
2026-08-18 lib: characterize the 6 tri-state cells; enable them in the SCL
    The tri-states were the silent failure in the characterization flow:
    CharLib has no high-impedance concept anywhere in its schema or code, but
    gen_charlib_config.py does not skip them -- Z has a function, TE_B is
    collected as an ordinary input, and the cell is configured as a two-input
    gate whose output ignores one input. CharLib emits an empty result,
    omit_on_failure swallows it, and the run log never mentions the cell.
    lctime is no substitute: it carries three_state but pins the enable and
    skips exactly the enable arcs.
    work/char_tristate.py measures all three arc classes directly against the
    shipped netlist: the combinationa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
2026-08-19 work: parameterize the characterization flow by PVT corner
    The library ships one corner (typ, 3.30 V, 25 C) and is to gain fast and
    slow. Seven scripts each hardcoded "mos_tt" and 3.3 V independently --
    the CharLib configuration, both leakage measurements, the bus-holder,
    tri-state and clock-gate characterizations, and the Liberty finalizer --
    so a second corner meant editing the same operating point in seven
    places and hoping. That is how a "fast" library ends up containing
    typical leakage.
    corners.py is now the single definition of a corner (process section,
    supply, temperature, and the Liberty filename it produces), and every
    script takes --corner. run_corner.sh drives one corner end to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
2026-08-19 doc: document the corner-driven characterization flow
    The regeneration instructions in the README and the library report still
    showed "./run_charlib.sh ../lib/sg13g2_stdcell_hv_typ_3p30V_25C.lib",
    which stopped working when the characterization flow became corner-driven
    in d40dd9f: run_charlib.sh now takes the corner and derives both the
    configuration and the output file from it, precisely so that the fast
    configuration cannot be run into the typ Liberty.
    Both now lead with ./run_corner.sh <corner>, which runs one corner end to
    end, and the README keeps the individual steps for when they are needed
    one at a time. The report notes why the order matters: the drive limits
    are derived from the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
2026-08-19 lib: characterize the 2 integrated clock gates -- all 84 cells now timed
    lgcp_1 and slgcp_1 were the last cells without a Liberty entry. CharLib
    has no statetable input form, so gen_charlib_config.py skips them by
    name; work/char_clockgate/ measures them directly instead: CLK->GCLK
    propagation on the 7x7 grid, setup and hold of GATE (and SCE) against the
    rising clock edge by bisection, minimum clock high and low time by
    bisection, per-state leakage with the latch driven into each state, and
    input capacitance by charge integration. The Liberty model carries the
    statetable, the internal state pin, state_function on GCLK and the
    clock_gate_* pin attributes, so a tool can recognise them as ICGs.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
2026-08-19 char_tristate: recompute HOLD_TOL when the corner changes
    HOLD_TOL is derived from VDD at module level, but the --corner block
    rebound VDD alone, so at any corner other than typ the keeper-hold check
    ran against the previous corner's rail: 4.58 % of VDD at fast, 5.5 % at
    slow, instead of the intended 5 %.
    It is a sanity threshold rather than a measured quantity, so no shipped
    data was ever wrong -- but it is the same "derived constant frozen at
    import" shape that already produced four defects in this refactor, and a
    tolerance that silently checks the wrong rail is exactly the kind that
    passes while meaning nothing.
2026-08-19 doc: add a step-by-step howto to the characterization report; ship Markdown
    The report explained what is measured and why, but not how to run it. It
    now carries a runbook: prerequisites (including the two environment
    details that cause most first-run failures -- the OSDI shim, and
    .spiceinit overriding OMP_NUM_THREADS), the six stages with the check
    that proves each one did something, how to add a corner, how to install
    into the PDK, and the five traps that cost the most time here.
    Also refreshed two things the clock-gate work made stale: the provenance
    table still said no clock-gate data was shipped, and the clock-gate
    section was written in the future tense. Both now report the measured
    r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
2026-08-19 char: scope the tri-state cache by corner; make stage 4 idempotent
    Three defects, all found by running a corner from scratch for the first
    time. The typ Liberty was built incrementally over many sessions, which
    hid every one of them.
    1. char_tristate's on-disk measurement cache is keyed by cell, slew and
    direction -- with no corner. The fast run therefore replayed the typ
    run's simulations and would have emitted typical tri-state timing into
    the fast Liberty. Nothing about the run looked wrong; it was caught
    only because the keeper-hold check saw a floating node sitting at
    3.3 V when the corner rail is 3.6 V. DECKS/LOGS/DATA/CACHE are now
    scoped by corner name, and the exi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
2026-08-19 doc: guarantee the PDFs fit the page; record the corner failure modes
    On paper `overflow-x: auto` does not scroll, it clips -- and a truncated
    shell command is indistinguishable from a complete one, so a reader
    cannot tell that anything is missing. Two code lines in the new howto
    were over the ~77-character text column and would have shipped cut off.
    Three changes, in order of how much they can be relied on:
    * fitcheck.py renders the real document and walks the laid-out box tree,
    failing if any box crosses the body's content edge. build.sh runs it
    before writing the PDF, so a clipped report cannot be produced at all.
    Validated against a deliberately non-wrapping control.
    *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
2026-08-19 doc: revert the hanging indent that broke code-block alignment
    The print rule added padding-left + text-indent: -1.4em to give wrapped
    listing lines a hanging indent. CSS text-indent applies to the first line
    of a block, not to each wrapped line, so it did not do that at all: it
    shifted the first line left and left every following line indented,
    destroying the alignment of code that is flush left in the source. Every
    listing in both reports was affected.
    Found by rasterising the pages and looking at them. fitcheck.py passed
    throughout -- correctly, since nothing crossed the margin; the defect was
    alignment, not overflow. A geometric check cannot see a document that is
    laid out wrongly but l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
2026-08-19 lib: characterize the fast corner (3.60 V, -40 C, mos_ff), all 84 cells
    sg13g2_stdcell_hv_fast_3p60V_m40C.lib: 84 cells, 668 timing tables,
    verify_lib PASS, and no waiver -- the xnor2_1 load-axis non-monotonicity
    that typ carries as a documented, pessimistic outlier does not occur at
    this corner.
    Getting here exposed four defects, every one of them invisible while typ
    was the only corner that had ever been built, and typ was built
    incrementally over many sessions rather than once from an empty
    directory:
    * char_tristate's measurement cache was keyed by cell/slew/direction
    with no corner, so the fast run replayed typ's simulations. Caught by
    the keeper-hold check seeing a node at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
2026-08-20 lib: characterize the slow corner; fix an ill-posed antenna-diode deck
    sg13g2_stdcell_hv_slow_3p00V_125C.lib (3.00 V, 125 C, mos_ss): 84 cells,
    668 timing tables, verify_lib PASS. All three PVT corners now ship, on
    identical slew and load grids so STA can interpolate across them, each
    paired with the matching sg13g2_io corner in the LibreLane config.
    The slow run needed no measurement repairs: delay 98/98 with no holes,
    mpw 16/16 with none pinned, suh 18/18, first pass. Running it at
    CG_JOBS=2 from the start avoided the thread oversubscription that cost
    the fast corner two rounds of rework.
    It did expose a defect in already-shipped data. The antenna-diode leakage
    deck left its signal pin d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
2026-08-20 views: add the Qucs-S schematics and symbols
    The thin-oxide library ships a complete Qucs-S view set and this one did
    not. Added: sch/qucs-s (84 schematics), sym/qucs-s (84 component XML plus
    the 45 shared gate-shape .sym files, carried over unchanged because the
    shapes are function-level), and the sch/ and sym/ READMEs the thin-oxide
    library has.
    The schematics are a device-level retarget of the thin-oxide originals
    rather than fresh drawings: the two libraries are topologically identical,
    so redrawing 920 devices could only introduce differences the transform
    cannot.
    Sizes come from the shipped SPICE netlist, never from a formula. A formula
    would be wrong in three ways this library actua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
    [sg13g2_hv_a21o_1.sch, sg13g2_hv_a21o_2.sch, sg13g2_hv_a21oi_1.sch, sg13g2_hv_a21oi_2.sch, sg13g2_hv_a221oi_1.sch, sg13g2_hv_a22oi_1.sch, sg13g2_hv_and2_1.sch, sg13g2_hv_and2_2.sch]
2026-08-20 doc: note the iic-osic-tools ngspice threading and Qucs-S setup issues
    Two environment issues that cost real time during the corner
    characterization, recorded separately from the library documentation
    because neither is a PDK or library bug.
    ngspice: the image ships ~/.spiceinit with num_threads=4, and
    OMP_NUM_THREADS is ignored entirely -- ngspice calls omp_set_num_threads()
    from its own variable and overrides the environment. A job-parallel flow
    therefore gets jobs x 4 threads by default, and the resulting deck
    timeouts read as measurement failures inside a bisection, which returns
    its search bound as if it were data. Measured table included.
    Qucs-S: the binary is off PATH, and libs.tech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
2026-08-20 doc: final consistency pass across README, reports and the PR
    Brings every document to the shipped state and removes the drift that
    accumulated while the three corners and the Qucs-S views landed.
    * README: Liberty section said "the 3.3 V typical corner" -- now three
    corners on identical axes; directory layout and a new "Using it"
    subsection cover sch/qucs-s and sym/qucs-s, including the symlink
    needed to expose them and the caveat about older container images.
    * Library report: the views bullet and the lib/ bullet still described
    one corner and one schematic front-end; adds a "The Qucs-S views"
    section with the three-way verification table, and two rows to the
    v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
2026-08-20 doc: fix five contradictions the previous pass missed
    A scripted sweep against measured ground truth found what reading did
    not. All five were passages describing an earlier state of the library:
    * library report: the Liberty prose still said 660 tables over 72 cells
    and 660/660 populated -- 668 over 74, at each of three corners.
    * library report: monotonicity appeared a second time as 2 141/2 142,
    outside the summary table the previous pass corrected. It is
    2 169/2 170, and the single waiver is typ-only.
    * methods report: "the 2 clock gates are still in progress" in the
    section that introduces the cells no characterizer reaches. All nine
    now ship measured Liberty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
2026-09-12 Address Alexey's review of #1207: tracks.info, the UDP view, guards
    Three findings from @b10346 on IHP-Open-PDK#1207, all real.
    tracks.info is no longer a copy of the G2 file. CMOS5L is a four-metal
    stack (Metal1-4 + TopMetal1); G2 adds Metal5 and TopMetal2, and rows for
    layers the tech LEF does not declare are meaningless to the router.
    write_tracks() now filters the G2 rows against the layer names the CMOS5L
    tech LEF actually declares, and asserts both that rows survive and that
    some were dropped -- a filter that silently passes everything is the same
    bug wearing a different hat. Result: 10 rows, Metal1-4 at X 0.48 / Y
    0.42 and TopMetal1 at 1.64/3.28, exactly the values Alexey gave.
    The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
2026-09-12 make_cmos5l_pr: derive tracks.info from the tech LEF, not from a copy
    The fix I wrote first was wrong about its own history. It filtered the G2
    tracks.info against the CMOS5L layer set and its commit message said the
    shipped file had been "a verbatim copy of the G2 file". It was not: it
    was a copy of sg13cmos5l_stdcell's, which is why it carried Metal1 X 0.42
    and TopMetal1 2.28 -- neither a G2 value nor a correct one. Filtering G2
    happened to land on the right numbers only because these are the G2 cells
    and the two tech LEFs declare identical pitches.
    Reading sg13cmos5l_tech.lef removes the luck. LEF gives DIRECTION, PITCH
    x y and OFFSET x y per routing layer, which is precisely a tracks.in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
